brianmaine157/axworthy-ghost-pulley/(commit log)

2026-10-06 Axworthy Ghost Pulley — public release
    [BOM.csv]
2026-10-07 Update BOM with acrylic sheet link and remove fan circuit
    Updated the BOM to include a link for the acrylic sheet and removed the fan circuit components.
2026-10-07 Update supplier and link for acrylic sheet in BOM
    Updated supplier information and added product link for acrylic sheet.
    [BOM.csv]
2026-10-08 Assembly Guide R1 -> R2; update doc links
2026-10-08 User Guide R0 -> R1 (adds motor-current/A4988 potentiometer section); update doc links
2026-10-09 Firmware: schedule re-homing (start+end), manual Home in Setup, reorder Setup (Learn last)
2026-10-18 Assembly Guide R2 -> R3 (latest schematics); update doc links
2026-10-18 BOM: +3 M3x6 SHCS (27->30) and +3 M3 heat-set inserts (28->31)
